racoonhead/eurorack/elements/hardware_design/panel/pcb_art/split/exciter/Exciter_preview.png

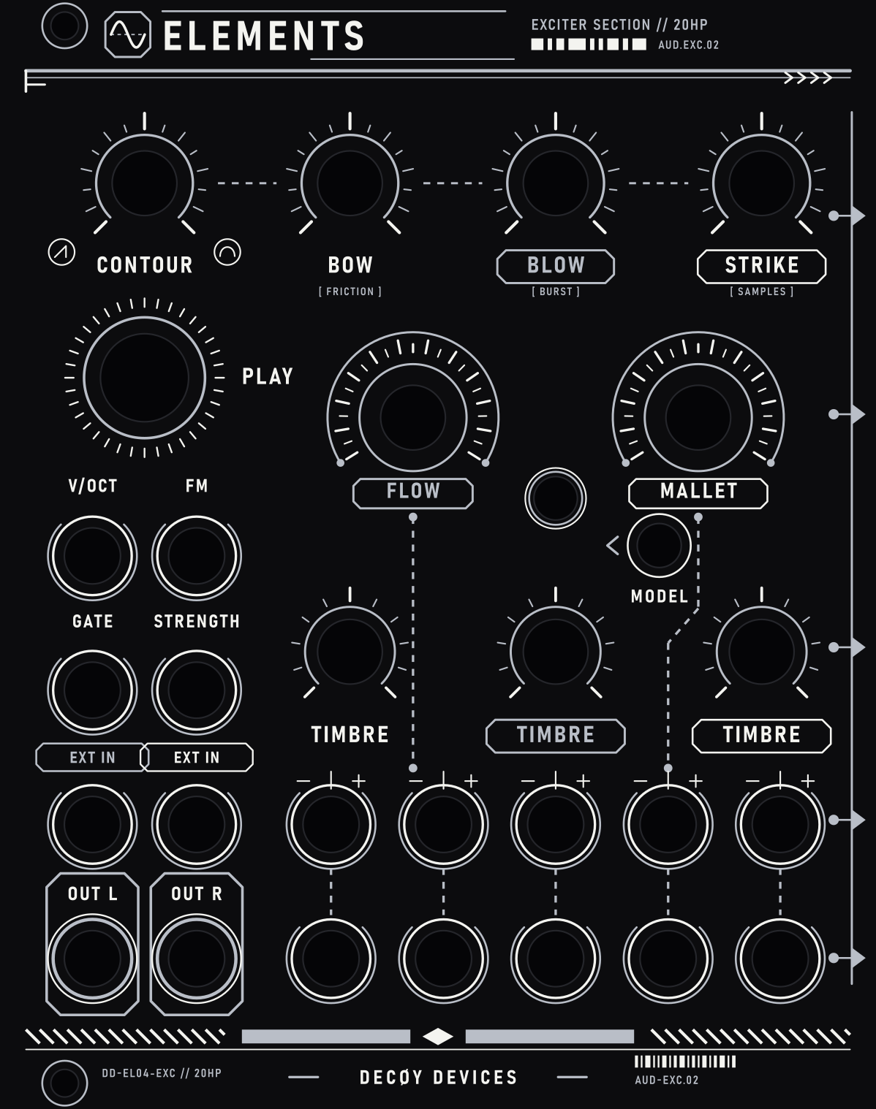
elements/hardware_design/panel/pcb_art/split/exciter/Exciter_preview.png
