racoonhead/eurorack/elements/hardware_design/panel/pcb_art/split/resonator/Resonator_preview.png

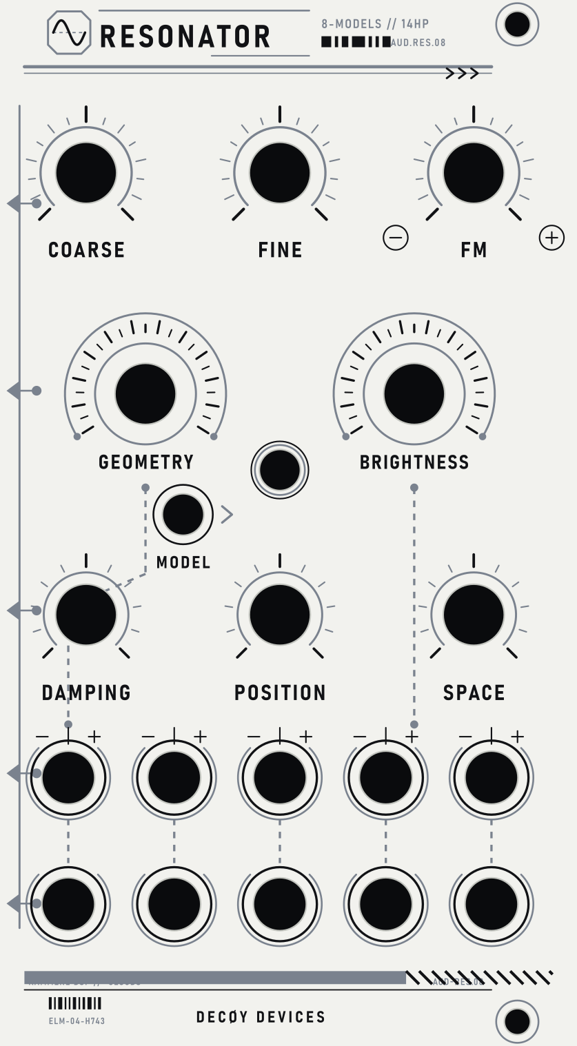
elements/hardware_design/panel/pcb_art/split/resonator/Resonator_preview.png
