racoonhead/eurorack/elements/instagram/slide1_elements_ii.png

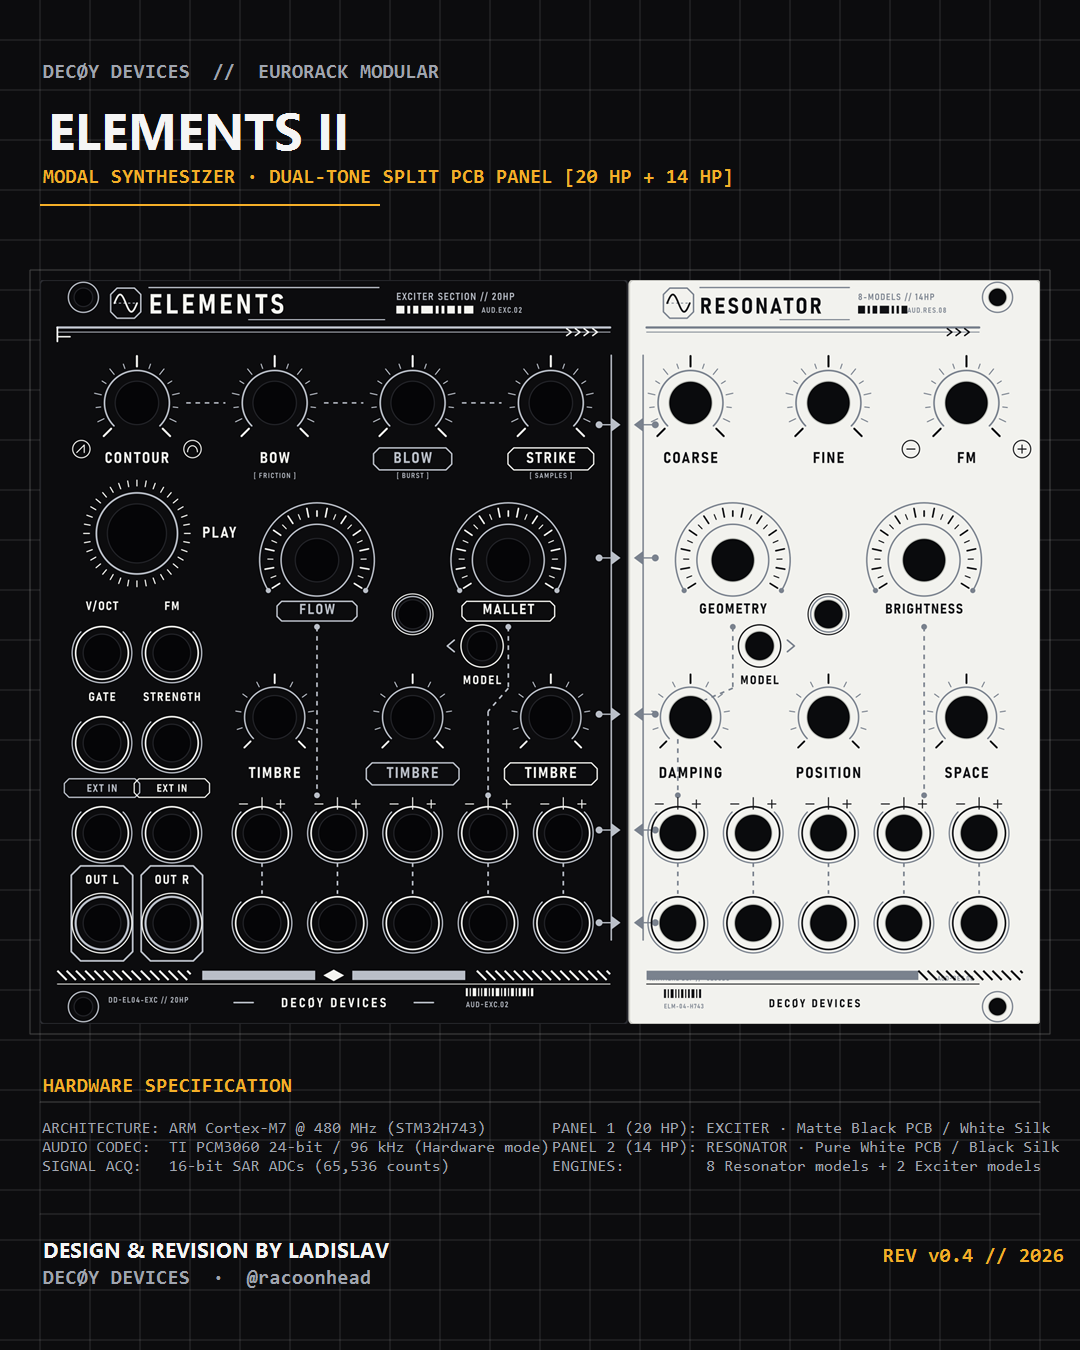
elements/instagram/slide1_elements_ii.png
