racoonhead/eurorack/elements/instagram/slide2_elements_ii_split.png

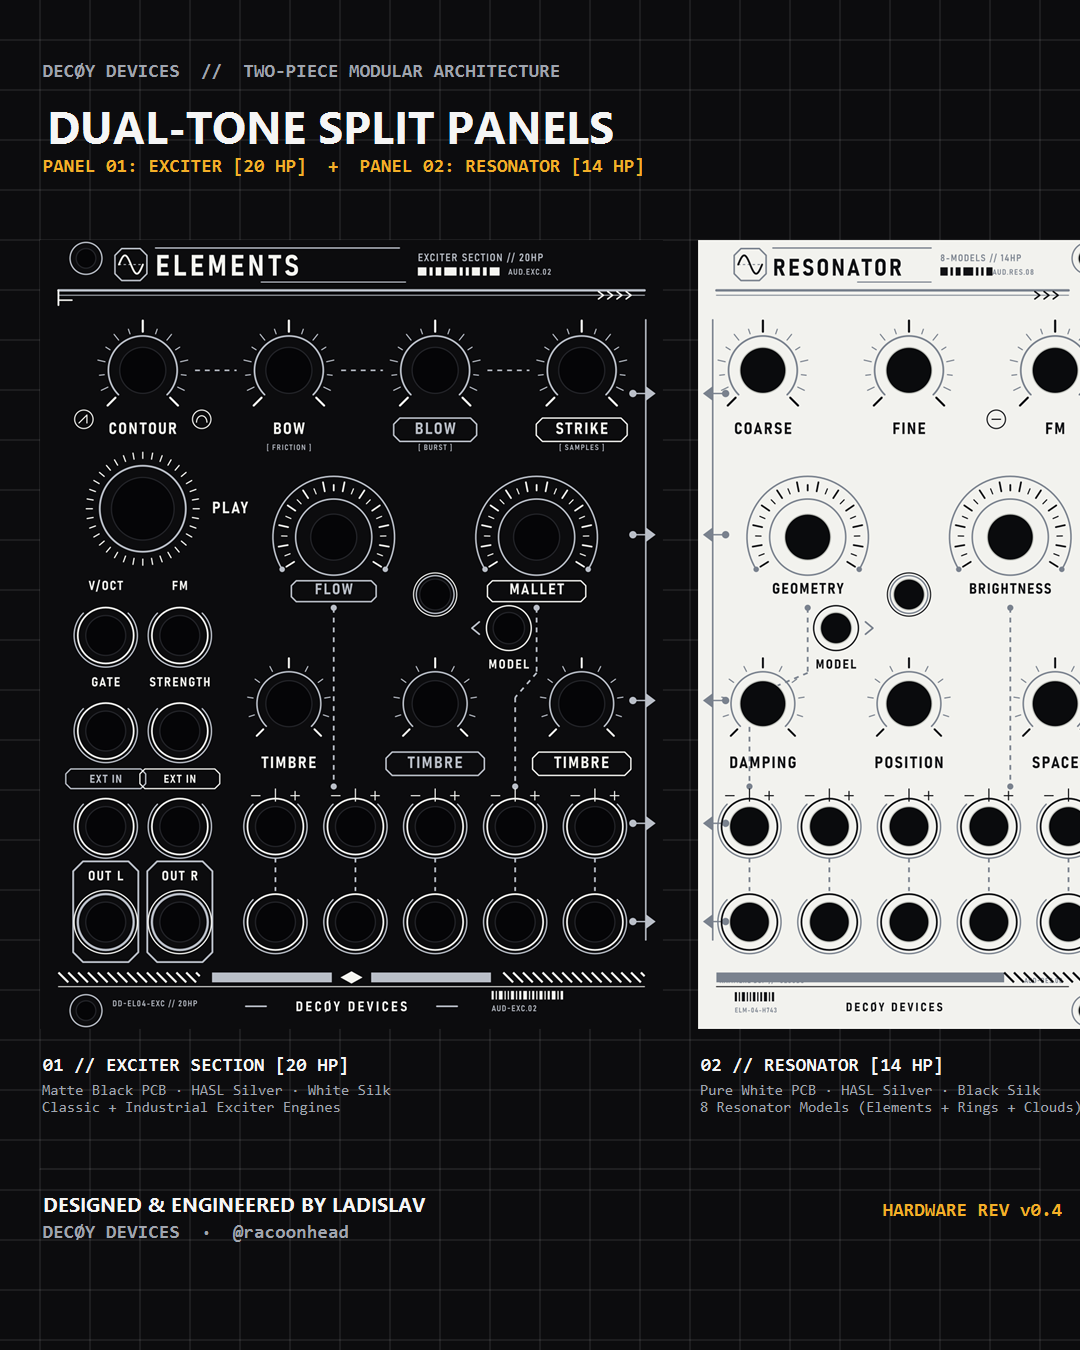
elements/instagram/slide2_elements_ii_split.png
