racoonhead/eurorack/STL_Panels/yarns-ALI-midi.stl

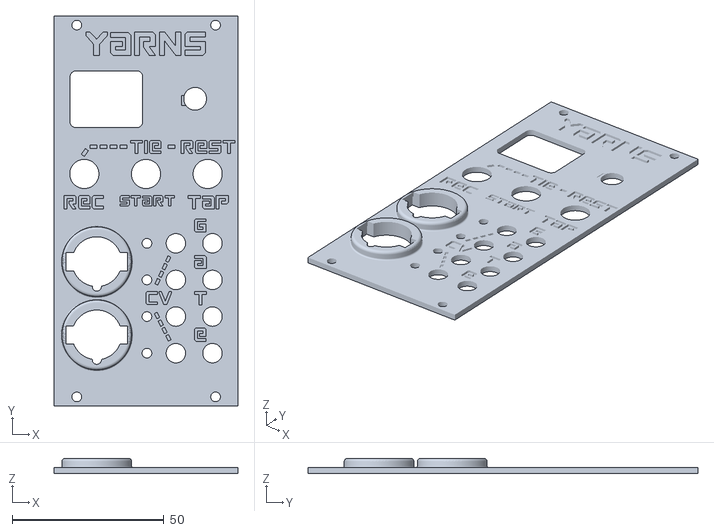
[picture p7: CAD file, 2022-05-30]
STL_Panels/yarns-ALI-midi.stl
60.6 x 128.6 x 5.00
