racoonhead/eurorack/STL_Panels/tides2.stl

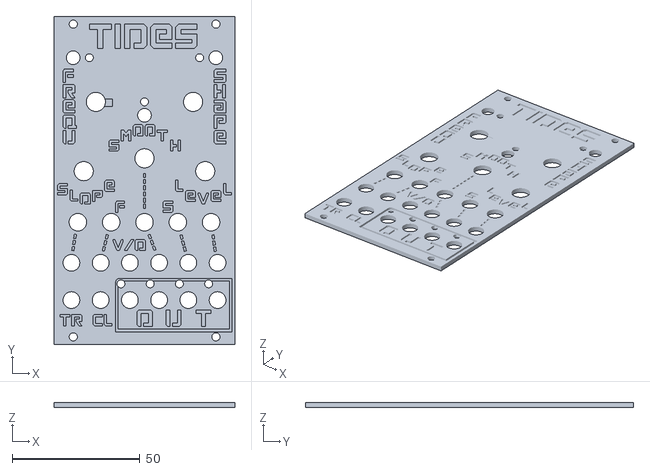
[picture p8: CAD file, 2022-05-30]
STL_Panels/tides2.stl
70.9 x 128.6 x 1.99
