racoonhead/eurorack/STL_Panels/marbles.stl

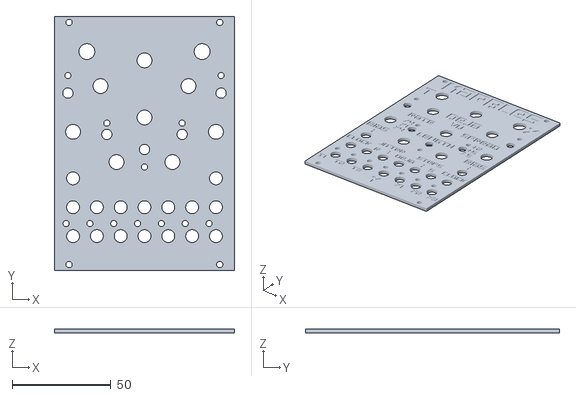
[picture p9: CAD file, 2022-05-30]
STL_Panels/marbles.stl
91.4 x 128.6 x 2.00
