racoonhead/eurorack/STL_Panels/braids.stl

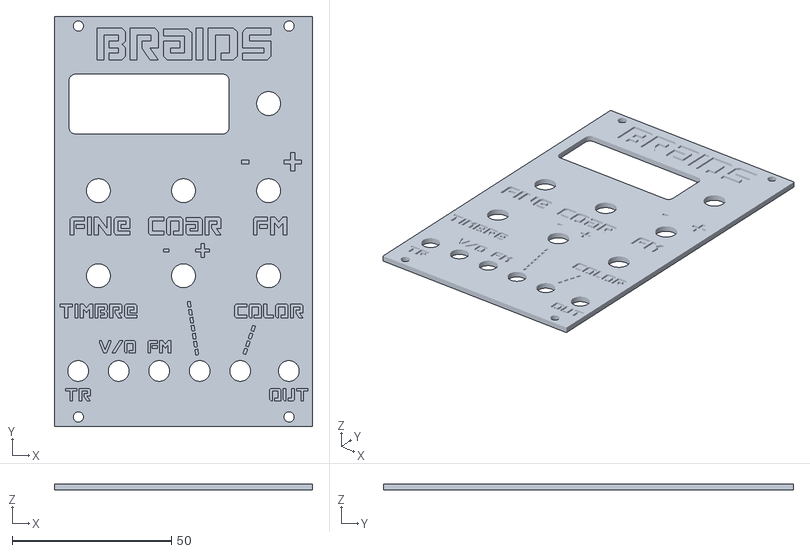
[picture p10: CAD file, 2022-05-30]
STL_Panels/braids.stl
81.0 x 128.6 x 2.00
