racoonhead/eurorack/STL_Panels/elements.stl

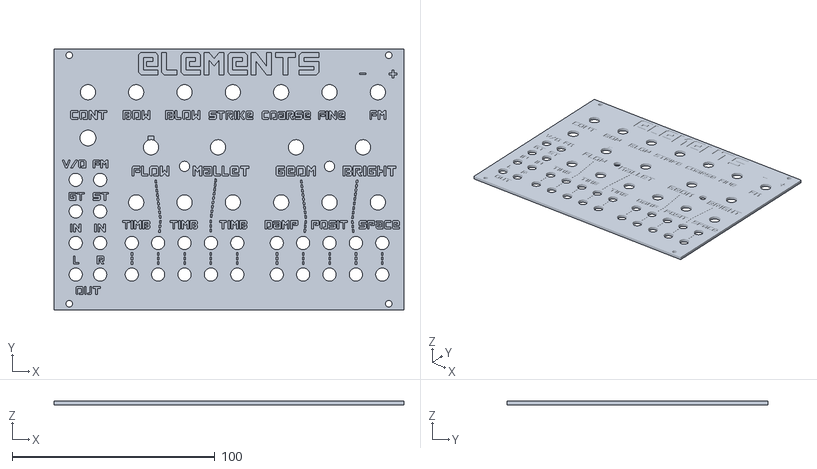
[picture p11: CAD file, 2022-05-30]
STL_Panels/elements.stl
172.6 x 128.6 x 2.00
