racoonhead/eurorack/STL_Panels/veils.stl

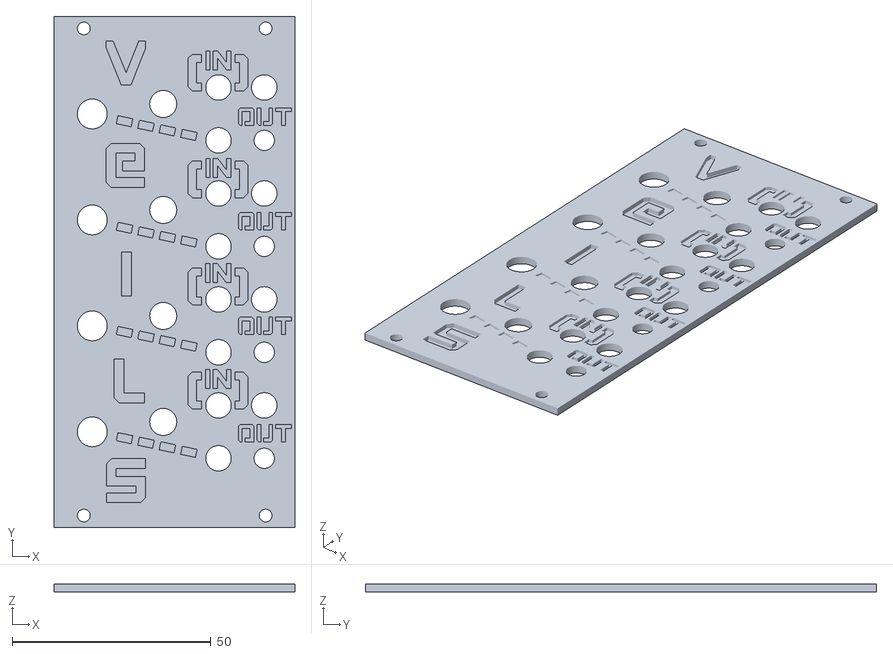
[picture p12: CAD file, 2022-05-30]
STL_Panels/veils.stl
60.6 x 128.5 x 2.00
