racoonhead/eurorack/(list of files, cad)

Other CAD files:
STL_Panels/Clouds.stl
STL_Panels/rings.stl
elements/hardware_design/panel/elements.3dm
