racoonhead/eurorack/elements/bootloader/bootloader.cc

// Copyright 2014 Emilie Gillet.
// 
// Author: Emilie Gillet (emilie.o.gillet@gmail.com)
// 
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
// See http://creativecommons.org/licenses/MIT/ for more information.

#include "stmlib/dsp/dsp.h"
#include "stmlib/system/bootloader_utils.h"
#include "stmlib/system/system_clock.h"

#include "elements/drivers/codec.h"
#include "elements/drivers/leds.h"
#include "elements/drivers/pots_adc.h"
#include "elements/drivers/switch.h"
#include "elements/drivers/system.h"

#include "elements/meter.h"

#include "stm_audio_bootloader/qpsk/packet_decoder.h"
#include "stm_audio_bootloader/qpsk/demodulator.h"

#include <cstring>

using namespace elements;
using namespace stmlib;
using namespace stm_audio_bootloader;

const double kSampleRate = 48000.0;
const double kModulationRate = 6000.0;
const double kBitRate = 12000.0;
const uint32_t kStartAddress = 0x08020000;

Codec codec;
Demodulator demodulator;
Leds leds;
Meter meter;
PacketDecoder decoder;
PotsAdc pots;
Switch push_switch;

int __errno;

// Default interrupt handlers.
extern "C" {

void NMI_Handler() { }
void HardFault_Handler() { while (1); }
void MemManage_Handler() { while (1); }
void BusFault_Handler() { while (1); }
void UsageFault_Handler() { while (1); }
void SVC_Handler() { }
void DebugMon_Handler() { }
void PendSV_Handler() { }

}

extern "C" {

enum UiState {
  UI_STATE_WAITING,
  UI_STATE_RECEIVING,
  UI_STATE_ERROR,
  UI_STATE_WRITING
};

volatile bool switch_released = false;
volatile UiState ui_state;
volatile int32_t gain = 4096;
volatile uint8_t pot_index = 0;

void UpdateLeds() {
  leds.set_gate(true);
  switch (ui_state) {
    case UI_STATE_WAITING:
      leds.set_gate(system_clock.milliseconds() & 128);
      break;

    case UI_STATE_RECEIVING:
      leds.set_gate(system_clock.milliseconds() & 32);
      {
        int32_t peak = meter.peak();
        if (peak < 16384) {
          leds.set_exciter(peak >> 6);
          leds.set_resonator(0);
        } else {
          leds.set_exciter(255);
          leds.set_resonator((peak - 16384) >> 6);
        }
      }
      break;

    case UI_STATE_ERROR:
      {
        bool on = system_clock.milliseconds() & 64;
        leds.set_exciter(on ? 0 : 255);
        leds.set_resonator(on ? 255 : 0);
      }
      break;

    case UI_STATE_WRITING:
      {
        leds.set_exciter(255);
        leds.set_resonator(0);
      }
      break;
  }
  leds.Write();
}

void SysTick_Handler() {
  HAL_IncTick();
  system_clock.Tick();
  pots.Scan();
  if (pots.last_read() == POT_EXCITER_BLOW_LEVEL) {
    int32_t gain_raw = pots.value(POT_EXCITER_BLOW_LEVEL) >> 1;
    gain = gain_raw * gain_raw >> 16;
  }
  push_switch.Debounce();
  if (push_switch.released(SWITCH_PLAY)) {
    switch_released = true;
  }
  UpdateLeds();
}

}

size_t discard_samples = 8000;

void FillBuffer(Codec::Frame* input, Codec::Frame* output, size_t n) {
  for (size_t i = 0; i < n; ++i) {
    input[i].r = Clip16(static_cast<int32_t>(input[i].r) * gain >> 12);
  }
  meter.Process(input, n);
  while (n--) {
    if (!discard_samples) {
      demodulator.PushSample(2048 + (input->r >> 4));
    } else {
      --discard_samples;
    }
    *output = *input;
    ++output;
    ++input;
  }
}

static size_t current_address;
static uint16_t packet_index;
const uint32_t kBlockSize = 0x10000;
const uint16_t kPacketsPerBlock = kBlockSize / kPacketSize;
uint8_t rx_buffer[kBlockSize];

void ProgramPage(const uint8_t* data, size_t size) {
  HAL_FLASH_Unlock();

  if ((current_address % 0x00020000) == 0) {
    const size_t sector_index = (current_address - 0x08000000) / 0x00020000;
    FLASH_EraseInitTypeDef erase_params = {};
    erase_params.TypeErase    = FLASH_TYPEERASE_SECTORS;
    erase_params.Banks        = (sector_index < 8) ? FLASH_BANK_1 : FLASH_BANK_2;
    erase_params.Sector       = sector_index;
    erase_params.NbSectors    = 1;
    erase_params.VoltageRange = FLASH_VOLTAGE_RANGE_4;
    uint32_t sector_error = 0;
    HAL_FLASHEx_Erase(&erase_params, &sector_error);
  }

  const size_t flash_block_size = 32;
  for (size_t written = 0; written < size; written += flash_block_size) {
    HAL_FLASH_Program(
        FLASH_TYPEPROGRAM_FLASHWORD,
        current_address,
        reinterpret_cast<uint32_t>(data));
    current_address += flash_block_size;
    data += flash_block_size;
  }
  HAL_FLASH_Lock();
}

void Init() {
  System sys;
  sys.Init(false);
  leds.Init();
  meter.Init(48000);
  push_switch.Init();
  if (!codec.Init(48000, CODEC_PROTOCOL_PHILIPS, CODEC_FORMAT_16_BIT)) { }
  if (!codec.Start(&FillBuffer)) { }
  sys.StartTimers();
  pots.Init();
}

void InitializeReception() {
  decoder.Init(20000, true);
  demodulator.Init(
      kModulationRate / kSampleRate * 4294967296.0,
      kSampleRate / kModulationRate,
      2.0 * kSampleRate / kBitRate);
  demodulator.SyncCarrier(true);
  decoder.Reset();
  current_address = kStartAddress;
  packet_index = 0;
  ui_state = UI_STATE_WAITING;
}

int main(void) {
  InitializeReception();
  Init();

  bool exit_updater = !push_switch.pressed_immediate();
  
  while (!exit_updater) {
    bool error = false;

    if (demodulator.state() == DEMODULATOR_STATE_OVERFLOW) {
      error = true;
    } else {
      demodulator.ProcessAtLeast(32);
    }
    
    while (demodulator.available() && !error && !exit_updater) {
      uint8_t symbol = demodulator.NextSymbol();
      PacketDecoderState state = decoder.ProcessSymbol(symbol);
      switch (state) {
        case PACKET_DECODER_STATE_OK:
          {
            ui_state = UI_STATE_RECEIVING;
            memcpy(
                rx_buffer + (packet_index % kPacketsPerBlock) * kPacketSize,
                decoder.packet_data(),
                kPacketSize);
            ++packet_index;
            if ((packet_index % kPacketsPerBlock) == 0) {
              ui_state = UI_STATE_WRITING;
              ProgramPage(rx_buffer, kBlockSize);
              decoder.Reset();
              demodulator.SyncCarrier(false);
            } else {
              decoder.Reset();
              demodulator.SyncDecision();
            }
          }
          break;
        case PACKET_DECODER_STATE_ERROR_SYNC:
        case PACKET_DECODER_STATE_ERROR_CRC:
          error = true;
          break;
        case PACKET_DECODER_STATE_END_OF_TRANSMISSION:
          exit_updater = true;
          break;
        default:
          break;
      }
    }
    if (error) {
      ui_state = UI_STATE_ERROR;
      switch_released = false;
      while (!switch_released);  // Polled in ISR
      InitializeReception();
    }
  }
  codec.Stop();
  pots.DeInit();
  Uninitialize();
  JumpTo(kStartAddress);
  while (1) { }
}
