racoonhead/eurorack/(notices)

Notices in the files:
elements/README.md:
License: MIT / CC-BY-SA
